Ruilx/GT-Clock/STM32/i2c-test.txt

// Disable animation and clear display
0xff 0
0x21 0xff 1
0x22 0
0x23 0 0
0x2f 0xff
0x20 1
0x20 0

// Clear animation and test program code
0xff 0
0x21 0xff 1
0x22 0
0x23 0 0
0x25 8 8	0 1 2 3 4
0x26 4 3 2 1 0
0x27 3 0x39
0x2f 0xff
0x20 1

// Flip display
0x11 1

//0x20 0
0xff 0
// Set layers
0x21 0xff 4 0 5 5 2
// Set layer parameters
0x22 0
0x23 7 20 4 1 1 1 2
//0x22 1 1	25 1 6 6	0 255	0x2 0 0 5 1 3 1
0x22 2 3	0 0 40 8	1 255 2 80 4 255	0 6 1 5 37
0x24	0x73 0x74 0x6d 0x33 0x32
0x22 3 2	0 0 40 8	2 255 4 255	2 40 0 26 37 72
//0x24	0x52 0x75 0x69 0x6c 0x78
0x24	0x54 0x68 0x69 0x73 0x20 0x69 0x73 0x20 0x61 0x20 0x73 0x74 0x72 0x69 0x6e 0x67 0
0x22 4
0x23 0 0x22
// Upload program code
0x25		72 3
0x26		0x09, 0x00, 0x02, 0x46, 0x09, 0x02, 0x03, 0x10, 0x05, 0x02, 0x05, 0x0b, 0x02, 0x05, 0x11, 0x0c,
0x27 0x10	0x00, 0x08, 0x01, 0x0a, 0x02, 0x00, 0x11, 0x03, 0x0d, 0x06, 0x03, 0x00, 0x09, 0x01, 0x0c, 0x08,
0x27 0x20	0x02, 0x0a, 0x02, 0x00, 0x11, 0x03, 0x0f, 0x06, 0x03, 0x00, 0x0b, 0x0d, 0x01, 0x03, 0x1b, 0x08,
0x27 0x30	0x03, 0x0a, 0x02, 0x00, 0x05, 0x02, 0x05, 0x0b, 0x10, 0x02, 0x04, 0x0c, 0x00, 0x08, 0x00, 0x0a,
0x27 0x40	0x02, 0x09, 0x00, 0x11, 0x03, 0x04, 0x0a, 0x00,
// Upload program data
0x28		0 3
// Update layers
0x2f 0xff
// Enable animation
0x20 1

// Program enable, auto restart
0x28 2

// RTC time display
//0x20 0
0xff 0
// Set layers
0x21 0xff 4 5 2
// Set layer parameters
0x22 0
0x23 7 20 4 1 1 1 2
0x22 1 2	0 0 40 8	2 80 4 255	0 2 1 6 37
0x22 2
0x23 0 0x22
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
0xfe 0x00 0x01 0x02 0x03 0x04 0x05 0x06 0x07 0x08 0x09 0x0a 0x0b 0x0c 0x0d 0x0e 0x0f 0x10 0x11 0x12 0x13
0xfe 0x00 0x01 0x02 0x03 0x04 0x05 0x06 0x07 0x08 0x09 0x0a 0x0b 0x0c 0x0d 0x0e 0x0f 0x10 0x11 0x12 0x13
0xfc 20 3
