Ruilx/GT-Clock/Board/Evaluation board/Stm32SMGPart.PDF

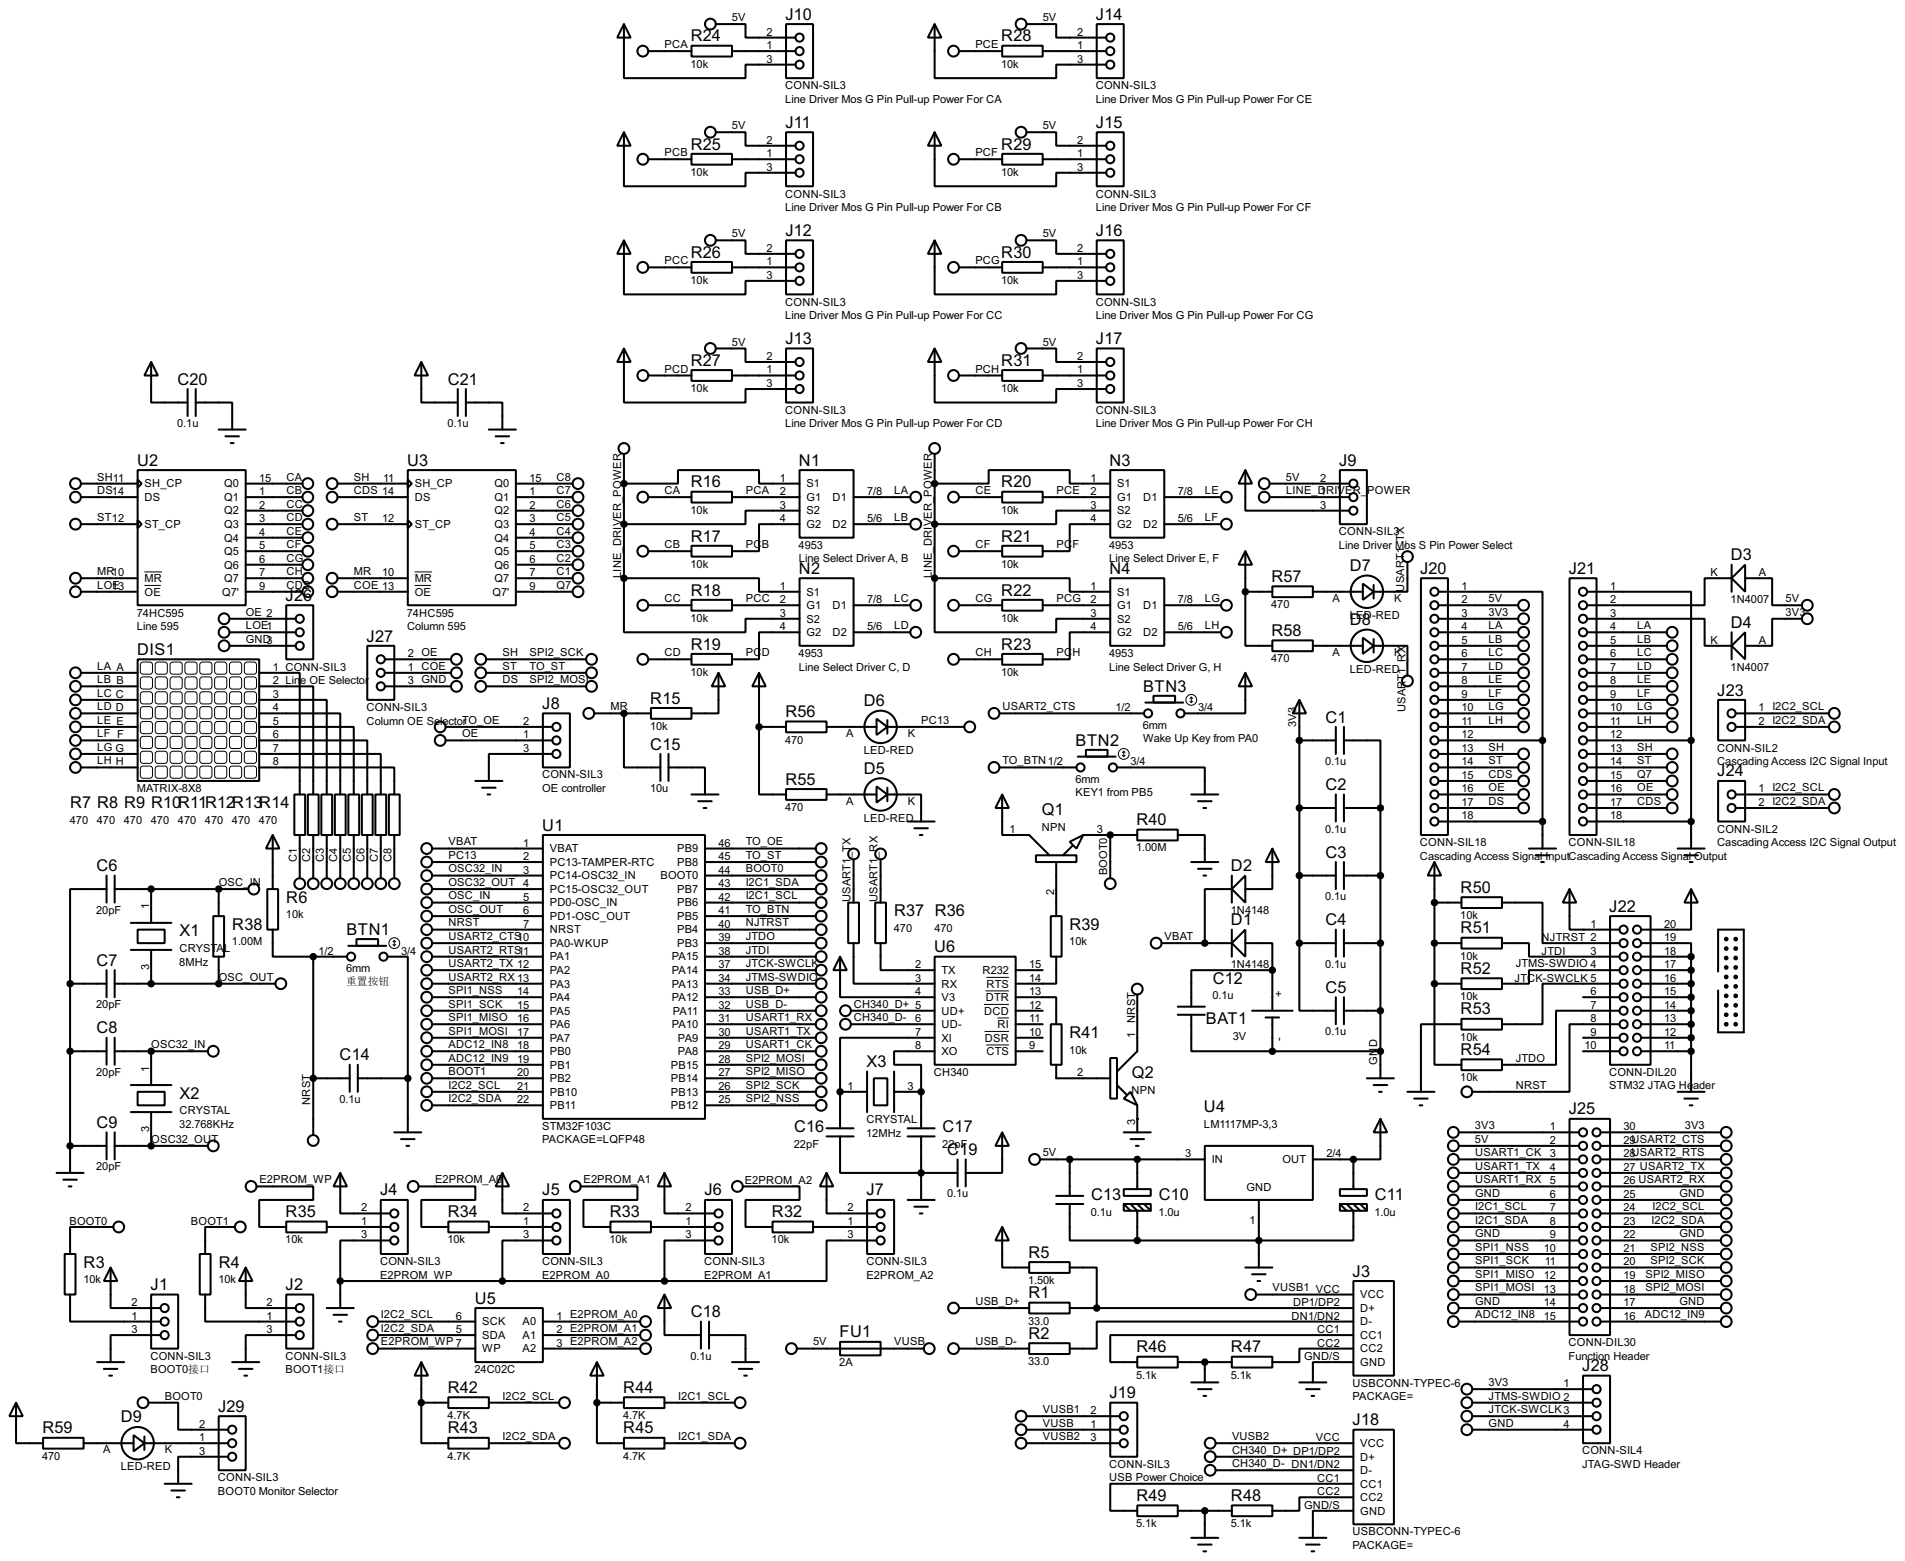
[picture p27: page 1]

CONN-SIL3
Line Driver Mos G Pin Pull-up Power For CD

Line Driver Mos G Pin Pull-up Power For CH

Line Driver Mos S Pin Power Select

CONN-SIL3 Column OE Selector

6mm Wake Up Key from PA0

CONN-SIL2 Cascading Access I2C Signal Input 1

CONN-SIL2 Cascading Access I2C Signal Output

CONN-SIL18 Cascading Access Signal Input

CONN-SIL18 Cascading Access Signal Output

CONN-SIL3 USB Power Choice
