Ruilx/GT-Clock/docs/schematics/GT-Clock_alpha.PDF

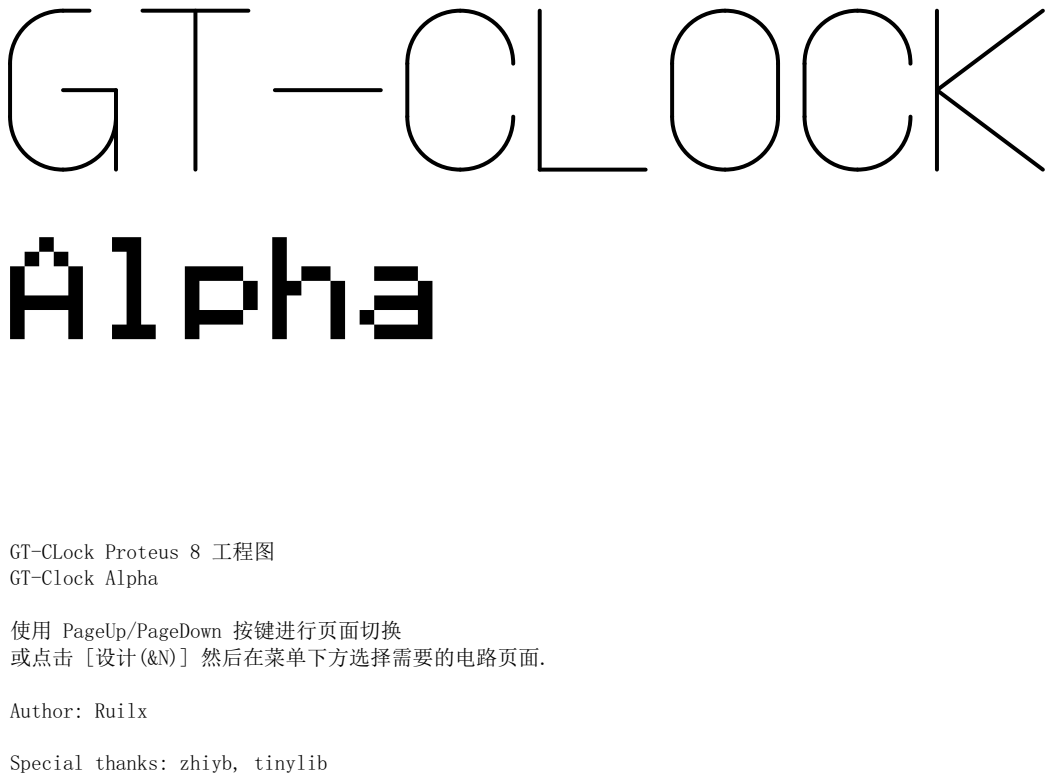
[picture p28: page 1]

GT-CLock Proteus 8 工程图
GT-Clock Alpha 使用 PageUp/PageDown 按键进行页面切换

Special thanks: zhiyb, tinylib

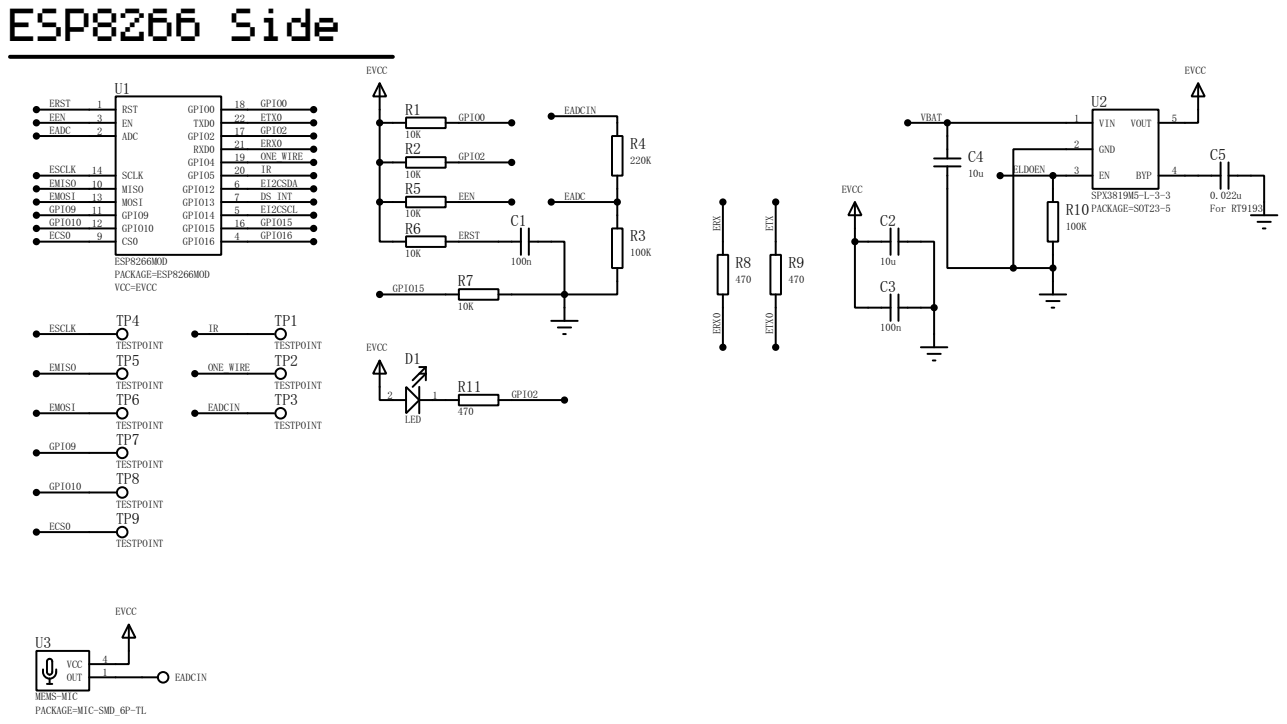
[picture p29: page 2]

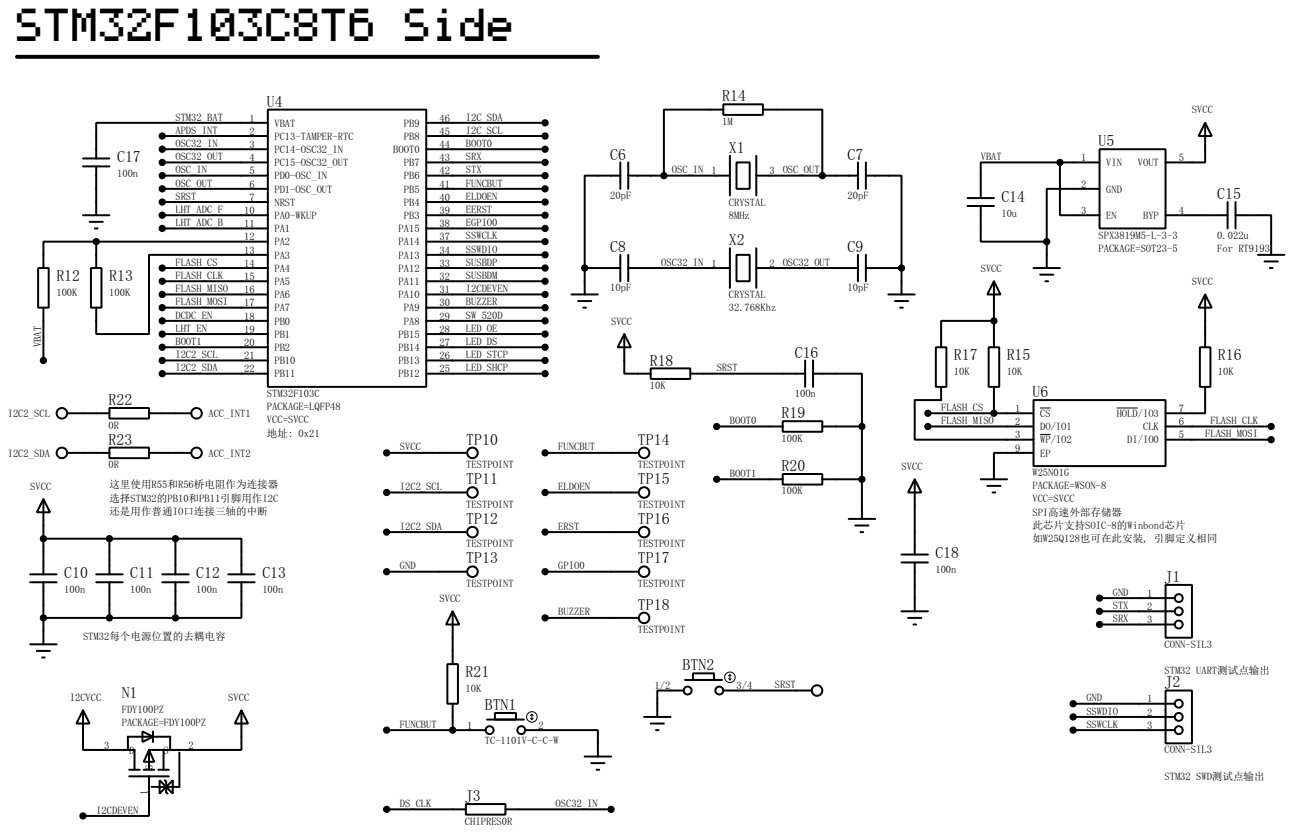
[picture p30: page 3]

FLASH_CS | 14

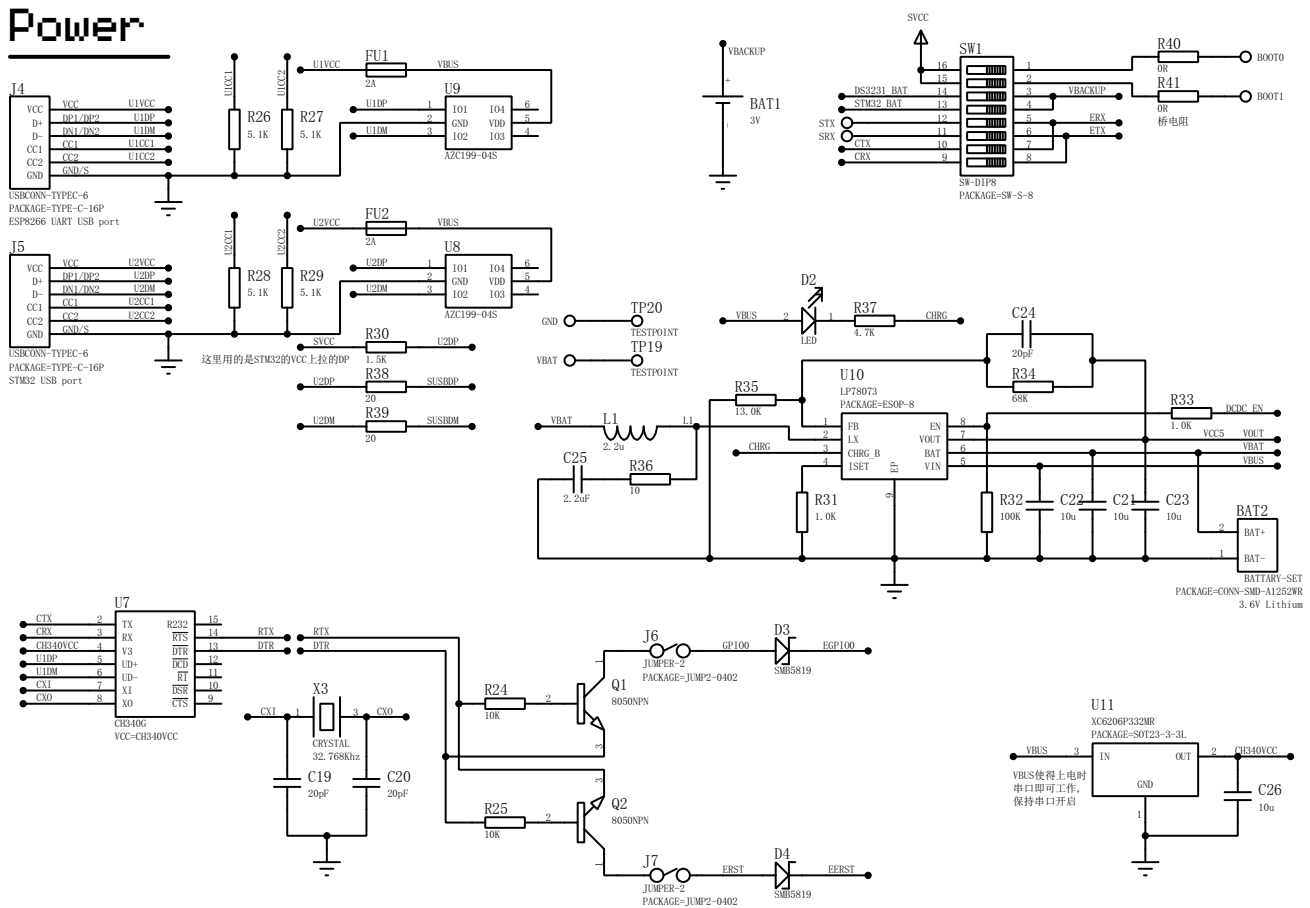
[picture p31: page 4]

CHRG 3 | 6

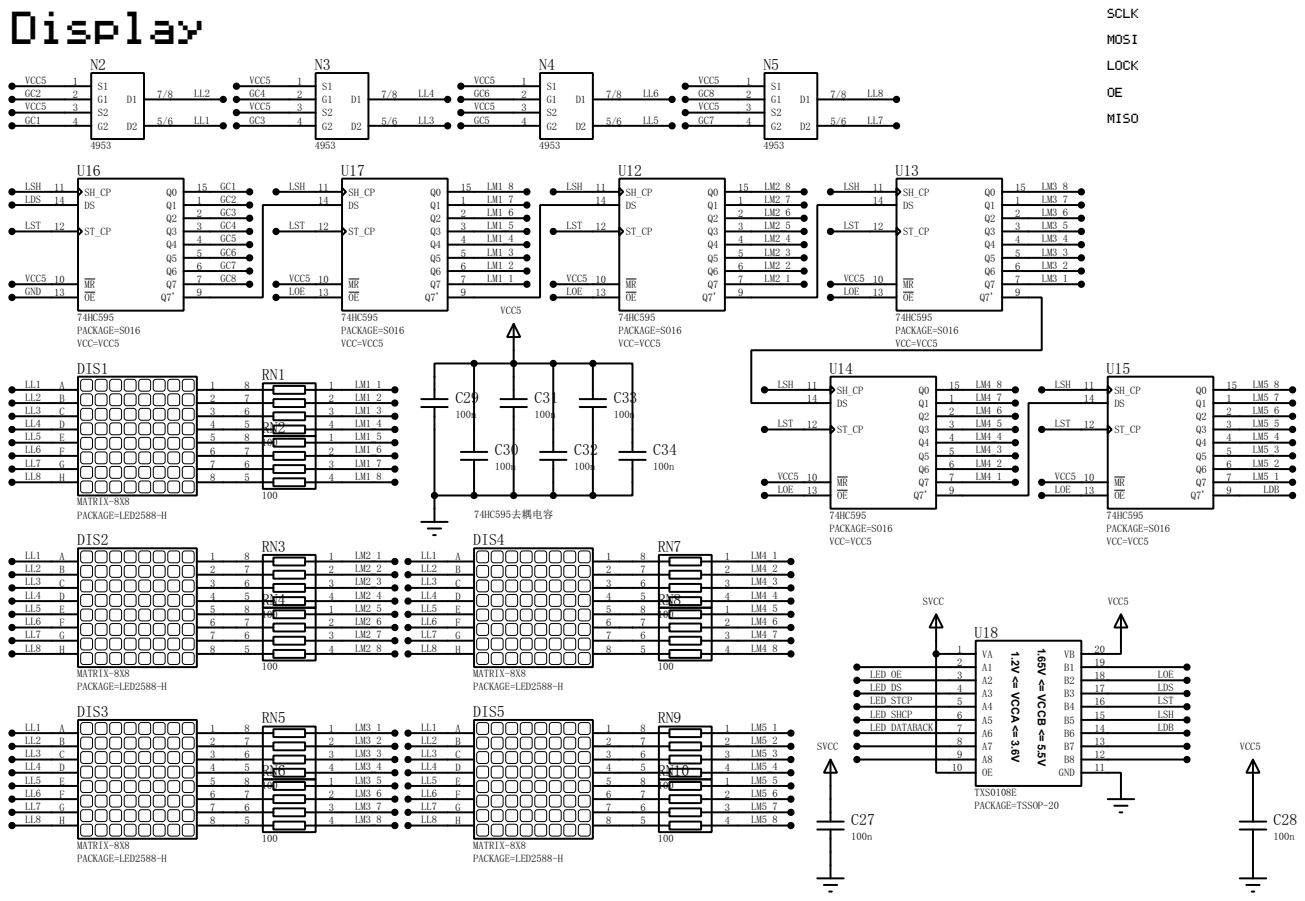
[picture p32: page 5]

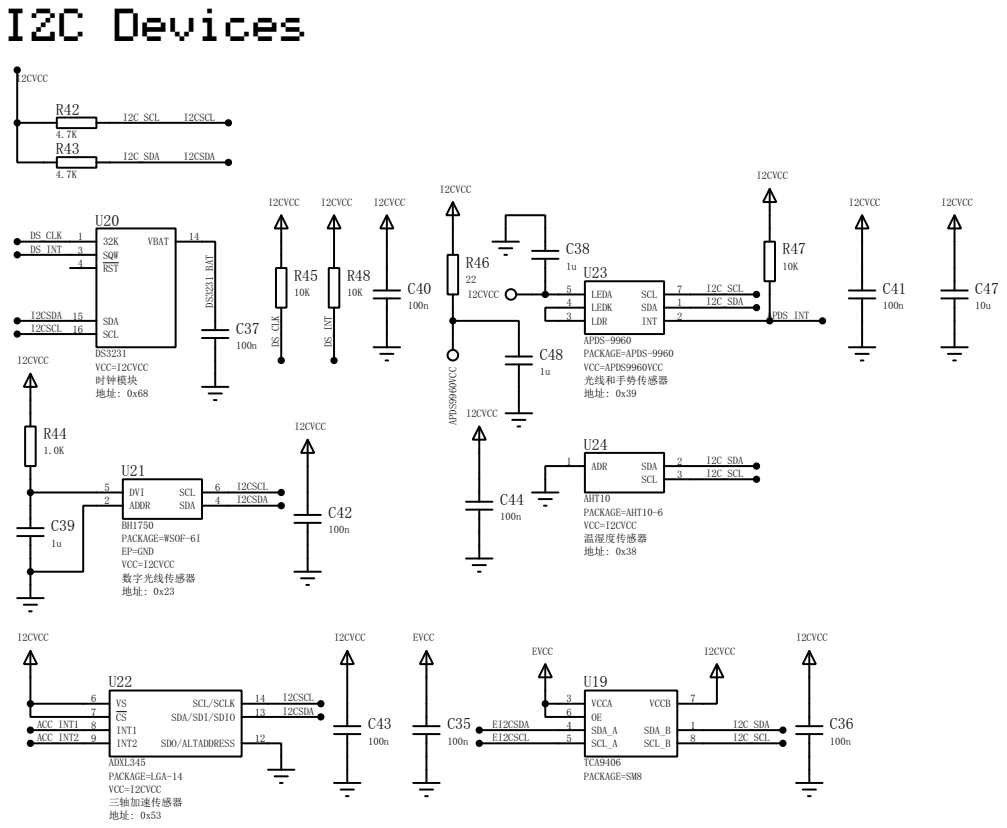
[picture p33: page 6]

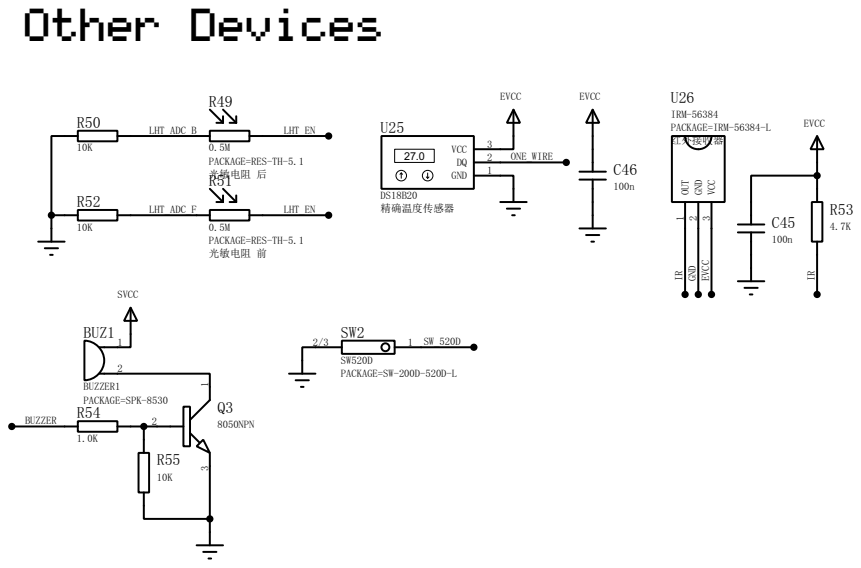
[picture p34: page 7]

PACKAGE=RES-TH-5.1 光敏电阻 后

PACKAGE=RES-TH-5.1 光敏电阻 前
