Ruilx/GT-Clock/(list of files, drawings)

Other design files:
Board/Evaluation board/Stm32SMGPart_release_v1.0_Patch1.pdsprj
