Ruilx/GT-Clock/(commit log)

2020-07-03 STM32 code initial
    [c232hm.cfg]
2020-07-03 Add some schematics and datasheets
2020-07-04 SPI & DMA * Timer LED matrix refresh, linear grayscale
2020-07-05 stm32: 256-step grayscale support
2020-07-05 stm32: Minor matrix refresh performance improvements
2020-07-05 stm32: Disable line drives instead at initilisation
2020-07-05 stm32: Debug FPS display
2020-07-05 stm32: Various optimisations
2020-07-05 Upload evaluation board infomation
    [Stm32SMGPart_release_v1.0_Patch1.pdsprj]
2020-07-05 stm32: I2C slave initial
2020-07-06 stm32: I2C offload TX/RX buffers to idle handler
2020-07-06 stm32: Matrix test pattern is now generated by code
2020-07-07 stm32: I2C register write initial
2020-07-07 stm32: I2C read & framebuffer direct data access
2020-07-07 stm32: Fix rare I2C racing condition
    [i2c_slave.c]
2020-07-07 stm32: Split I2C registers into a separate logic file
2020-07-07 stm32: Move FPS debug print to logic, and make it optional
2020-07-08 stm32: Double frame buffer
2020-07-08 stm32: Split I2C functions into separate files
2020-07-08 stm32: Animation initial
2020-07-08 stm32: Sine animation initial
2020-07-08 stm32: Update INIT and IDLE handler syntax, use LUT for sine animation
2020-07-08 stm32: Rename animation to layers, add some layers
2020-07-09 stm32: Update reset handler, add some more layer factors
    [logic_layer_const.c, logic_layer_sine.c, logic_layers.c, logic_layers.h, matrix.c, system.c]
2020-07-09 stm32: Fonts initial
2020-07-09 stm32: Minor fonts changes
2020-07-09 stm32: Remove fonts symlink
2020-07-09 stm32: Rename submodule CMSIS to cmsis
2020-07-09 stm32: Add fonts.qbs, try to fix reset handler assembly
    [logic_layer_string.c]
2020-07-09 stm32: String layer initial
2020-07-09 stm32: Move layer data init to logic_layers.c
2020-07-10 stm32: I2C layer control initial
2020-07-10 stm32: Fix some I2C layers control bugs
    [logic_layers.c]
2020-07-10 stm32: Add I2C layer private data access for string layer
2020-07-11 stm32: Double buffering layer configurations, move update to software interrupt
2020-07-11 stm32: Add starting offset to i2C layer stack function
2020-07-11 stm32: Layer mixer initial
2020-07-11 stm32: Reorder I2C mixer data access
2020-07-12 stm32: Use start layer 0xff to reset all layers, fix sine wave period
    [logic_layer_sine.c, logic_layers.c]
2020-07-12 stm32: Half-period sine wave support
2020-07-12 stm32: Reduce some code size
2020-07-17 stm32: Fix negative sine wave pattern
    [logic_layer_sine.c, main.c, matrix.c]
2020-07-17 stm32: Save some space by using float variant of FP math functions
2020-07-23 stm32: I2C DMA mode working initial, general performance improvements
2020-07-23 stm32: I2C fixes and general improvements
    [i2c_slave.c, main.c]
2020-07-25 stm32: Reduce LED matrix SPI transfer
2020-07-25 stm32: I2C separate debug levels
2020-07-25 stm32: Layer String scrolling support
2020-07-25 stm32: Fixed active layer switching
    [logic_i2c_layers.c, logic_layers.c, logic_layers.h, main.c]
2020-07-26 stm32: General optimisations
2020-07-26 stm32: Layer String avoid scrolling issue in case animation tick skipped
    [logic_layer_string.c]
2020-07-26 stm32: Option to disable stdio and syscalls
2020-07-26 stm32: Also remove heap space when stdio and syscalls are disabled
2020-07-26 stm32: Layer Bitmap initial
2020-07-27 stm32: Flip matrix display
    [logic_i2c_fb.c, matrix.c, matrix.h]
2020-07-27 stm32: Layer program procesor initial
2020-07-27 stm32: More RISC optimised layer program opcodes
2020-07-27 stm32: Somewhat more complex animation program
2020-07-28 stm32: RTC initial and chip UID report
2020-07-28 stm32: Fix I2C TX DMA circular mode not clearing interrupt
    [i2c_slave.c]
2020-07-28 stm32: Improve RTC idle counter read performance
2020-07-28 stm32: I2C RTC time read/set and layer program
2020-09-07 STM32: Switch to I2C1 + SPI2
2020-09-08 STM32: Fix debug GPIO conflicting with LED matrix
    [i2c_slave.c, main.c, matrix.c]
2020-09-09 STM32: Initial SPI1 and buttons support
2020-09-09 STM32: Add SysTick idle thread callback, more button IRQ code comments
2020-10-24 Use button to control ESP and display power for testing for now
2020-10-24 stm32: Fix my stupid typo
    [gpio.c]
2020-11-01 stm32: Reverse LED matrix horizontal direction
    [matrix.c]
2020-11-02 stm32: Negative values in layer set now leaves some layers unchanged
